slcz/hummingbird/kicad/IO.sch

## KiCad design kicad/IO.sch (2020-08-09)

Schematic: IO.sch

Parts:
A1: Arduino_Nano_v3.x; Arduino_Nano
BZ1: Buzzer
D1: LED
IN1: 74HC374
IODEV_SEL1: 74HC138
LCD16x2: RC1602A
OUT1, OUT2: 74HC377
R2: R220
R3: R1K
R4: R330
R5, R6: R10K
RV1: R_POT
SER1: 74HC164
SER2: 74HC165
SWDOWN1: SW_Push
SWUP1: SW_Push
