slcz/hummingbird/kicad/PGM_PC_PHASE.sch

## KiCad design kicad/PGM_PC_PHASE.sch (2020-08-09)

Schematic: PGM_PC_PHASE.sch

Parts:
C1: 10uf; CP_Axial_L10.0mm_D4.5mm_P15.00mm_Horizontal
OSC1: 2.000MHZ; Oscillator_DIP-14
PC1, PC2, PC3: 74HC163; DIP-16_W7.62mm
PHASE1: 74HC163; DIP-16_W7.62mm
PROGRAM_STORE1: 28c64
R1: R10K; R_Axial_DIN0204_L3.6mm_D1.6mm_P1.90mm_Vertical
RST_BL_DONE1: 74HC74
SW1: SW_Push; SW_DIP_SPSTx01_Piano_10.8x4.1mm_W7.62mm_P2.54mm
U1: 74HC08; DIP-14_W7.62mm
U5: 74HC02
