slcz/hummingbird/kicad/RAM_ADDR.sch

## KiCad design kicad/RAM_ADDR.sch (2020-08-09)

Schematic: RAM_ADDR.sch

Parts:
ADDRESS_LOCK1: 74HC374
ADDRESS_MUX1, ADDRESS_MUX2, ADDRESS_MUX3: 74HC157; DIP-16_W7.62mm
FETCH1: 74HC377; DIP-16_W7.62mm
OPERAND_BUF1: 74HC244; DIP-20_W7.62mm
OPRND1, OPRND2: 74HC157; DIP-16_W7.62mm
SRAM1: CY7C199; DIP-28_W7.62mm
U1: 74HC08
U2: 74HC32; DIP-14_W7.62mm
U3: 74HC21
U5: 74HC02
