slcz/hummingbird/kicad/UCODE_ALU.sch

## KiCad design kicad/UCODE_ALU.sch (2020-08-09)

Schematic: UCODE_ALU.sch

Parts:
ADDRESS_DECODER1: 74HC157; DIP-16_W7.62mm
ALU1, ALU2: 74HC181; DIP-24_W15.24mm
AREG1: 74HC377
AREG_BUF1: 74HC244; DIP-20_W7.62mm
FLAG1: 74HC173; DIP-16_W7.62mm
U1: 74HC08; DIP-14_W7.62mm
U3: 74HC21; DIP-14_W7.62mm
U4: 74HC02; DIP-14_W7.62mm
UCODE_1, UCODE_2: 28c64; DIP-24_W15.24mm_Socket
