slcz/hummingbird/assembler/README.md

Usage: cpp <filename> | python asm

Generate program.h and rom0.rom files. Rom0.rom files can be copied to
hdl directory for hardware simulation. Program.h file can be used to program
the EEPROM.
