slcz/hummingbird/hdl/ttl_74377.v

module ttl_74377(
    input clk,
    input  [7:0] d,
    output [7:0] q,
    input e
);
    logic [7:0] data;
    assign q = data;
    always_ff @(posedge clk)
    begin
        if (!e & clk)
            data <= d;
    end
    logic [31:0] rnd;
    initial begin
        rnd = $random();
        data = rnd[7:0];
    end
endmodule
