slcz/hummingbird/(commit log)

2020-06-24 add nop instructions to print status
2020-06-29 KiCad files
    [IO.sch, PGM_PC_PHASE.sch, RAM_ADDR.sch, UCODE_ALU.sch, hummingbird.sch]
2020-06-29 bug fixes for kicad
    [IO.sch, PGM_PC_PHASE.sch, RAM_ADDR.sch, UCODE_ALU.sch]
2020-08-06 board v1.1, ucode g0.1
    [PGM_PC_PHASE.sch, RAM_ADDR.sch, UCODE_ALU.sch, hummingbird.sch]
2020-08-09 update hummingbird schematics
    [IO.sch, PGM_PC_PHASE.sch, RAM_ADDR.sch, UCODE_ALU.sch]
2020-08-09 arduino IO processor code
2020-08-09 add assembler directory
    [74181_table.csv]
2020-08-09 update sample programs
2020-08-15 print offset in the line number
2020-08-16 fixing assembler
